brianthornock/nightshift/NightShift_FullSchematic.png

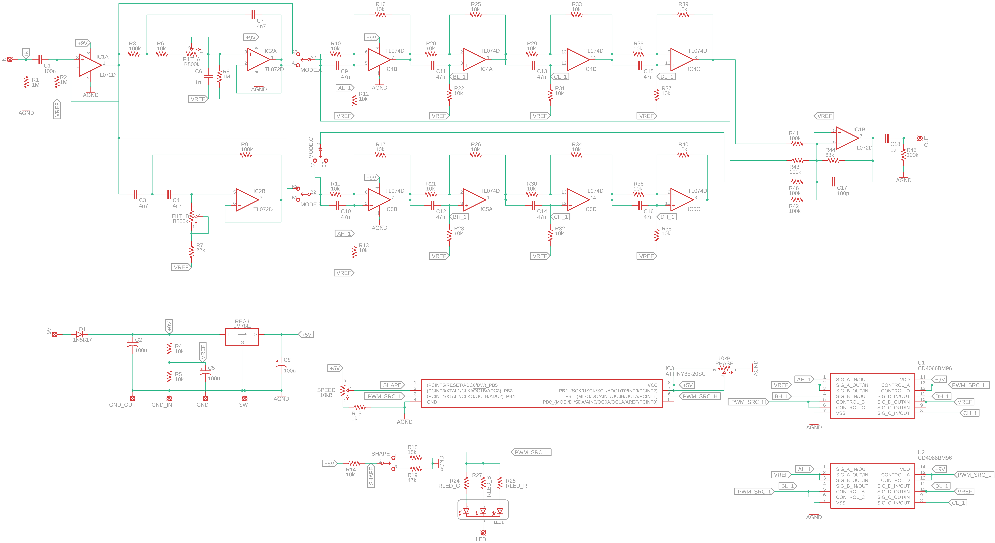
NightShift_FullSchematic.png
